tinyledmatrix/matrixSAO/README.md

# matrixSAO
tiny led matrix SAO

see also here:
https://hackaday.io/project/202620
