tinyledmatrix/matrixSAO/Firmware/linkUtilityScreenshoot.png

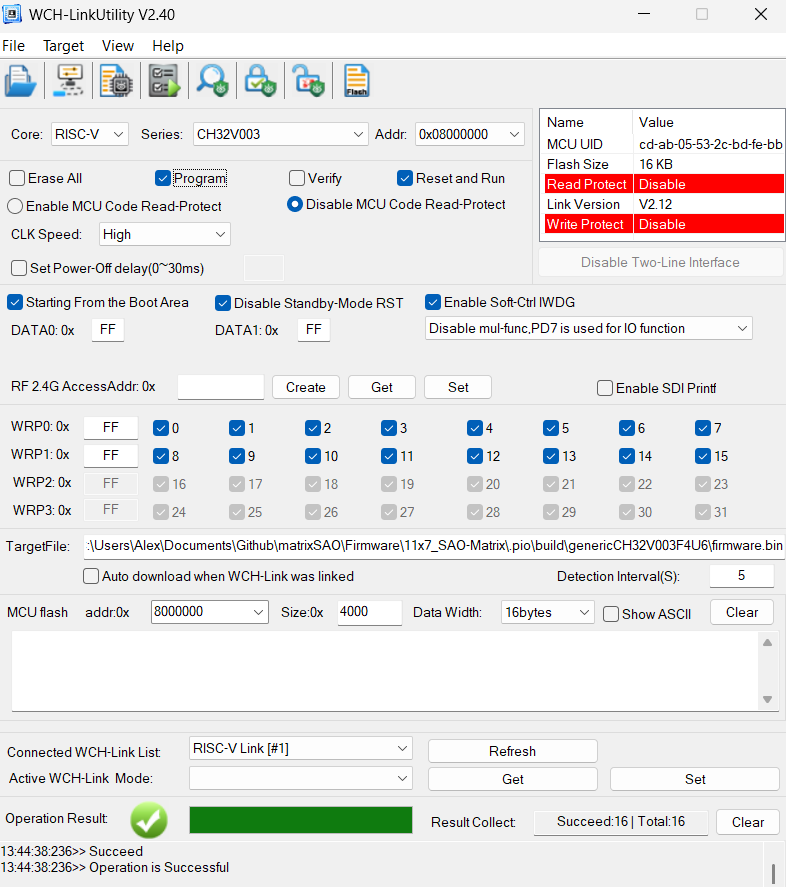
Firmware/linkUtilityScreenshoot.png
