tinyledmatrix/matrixSAO/Mechanical/MatchBoxHolder.3mf

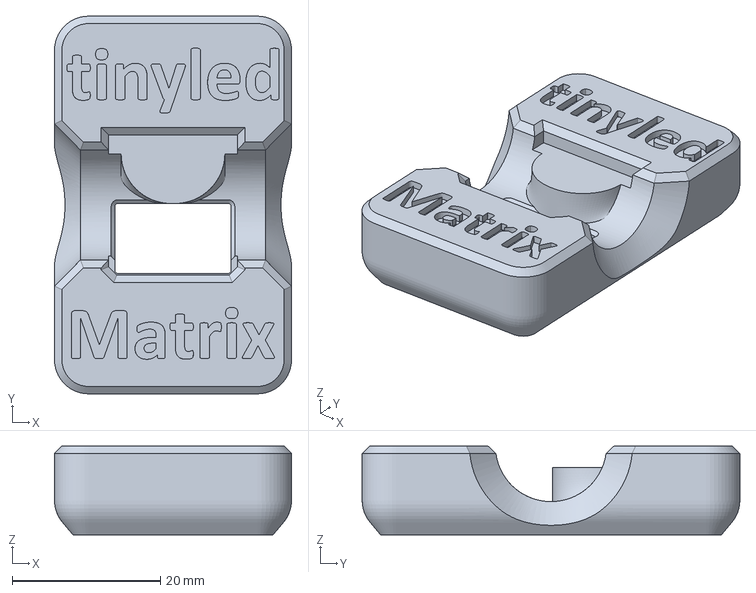
[picture p2: CAD file, 2025-03-15]
Mechanical/MatchBoxHolder.3mf
32.0 x 51.0 x 12.0 mm
