tinyledmatrix/matrixSAO/(list of files, cad)

Other CAD files:
Mechanical/holder.stl
