tinyledmatrix/matrixSAO/Hardware/matrixSAO/matrixSAO.kicad_pcb

## KiCad design Hardware/matrixSAO/matrixSAO.kicad_pcb (2025-02-26)

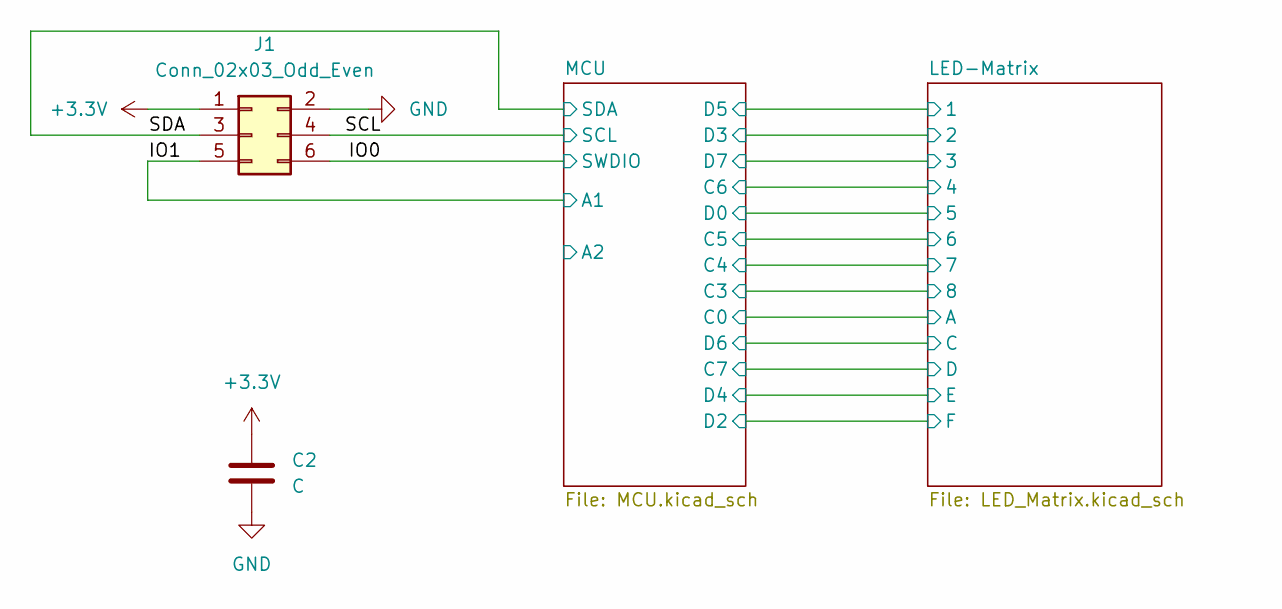
[picture p3: schematic matrixSAO.kicad_sch]

Parts:
C2: C; C_0402_min; LCSC C16772
J1: Conn_02x03_Odd_Even; IDC-Header_2x03_P2.54mm_Vertical; LCSC C4749192

Connections:
+3.3V: C2.2, J1.1; also elsewhere on the board
/IO0: J1.6; also elsewhere on the board
/IO1: J1.5; also elsewhere on the board
/SCL: J1.4; also elsewhere on the board
/SDA: J1.3; also elsewhere on the board
GND: C2.1, J1.2; also elsewhere on the board

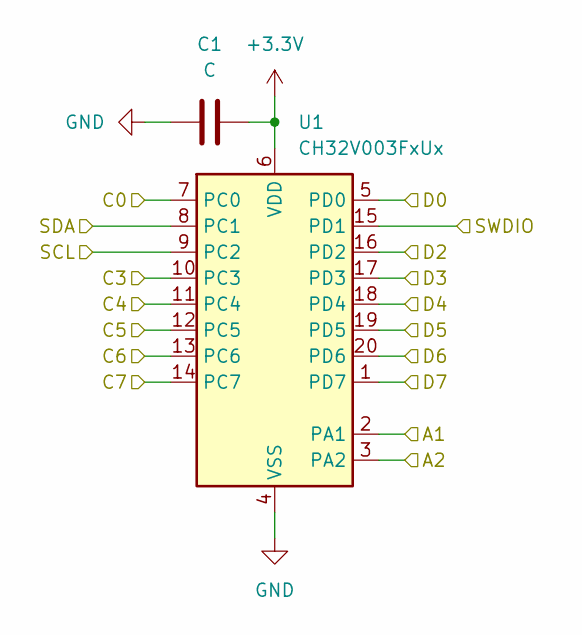
[picture p4: schematic MCU.kicad_sch]

Parts:
C1: C; C_0402_min; LCSC C16772
U1: CH32V003FxUx; QFN-20-1EP_3x3mm_P0.4mm_EP1.65x1.65mm; LCSC C5299908

Connections:
+3.3V: C1.2, U1.6 (VDD); also elsewhere on the board
/IO0: U1.15 (PD1); also elsewhere on the board
/IO1: U1.2 (PA1); also elsewhere on the board
/LED-Matrix/1: U1.19 (PD5); also elsewhere on the board
/LED-Matrix/2: U1.17 (PD3); also elsewhere on the board
/LED-Matrix/3: U1.1 (PD7); also elsewhere on the board
/LED-Matrix/4: U1.13 (PC6); also elsewhere on the board
/LED-Matrix/5: U1.5 (PD0); also elsewhere on the board
/LED-Matrix/6: U1.12 (PC5); also elsewhere on the board
/LED-Matrix/7: U1.11 (PC4); also elsewhere on the board
/LED-Matrix/8: U1.10 (PC3); also elsewhere on the board
/LED-Matrix/A: U1.7 (PC0); also elsewhere on the board
/LED-Matrix/C: U1.20 (PD6); also elsewhere on the board
/LED-Matrix/D: U1.14 (PC7); also elsewhere on the board
/LED-Matrix/E: U1.18 (PD4); also elsewhere on the board
/LED-Matrix/F: U1.16 (PD2); also elsewhere on the board
/MCU/A2: U1.3 (PA2)
/SCL: U1.9 (PC2); also elsewhere on the board
/SDA: U1.8 (PC1); also elsewhere on the board
GND: C1.1, U1.4 (VSS), U1.21 (VSS); also elsewhere on the board

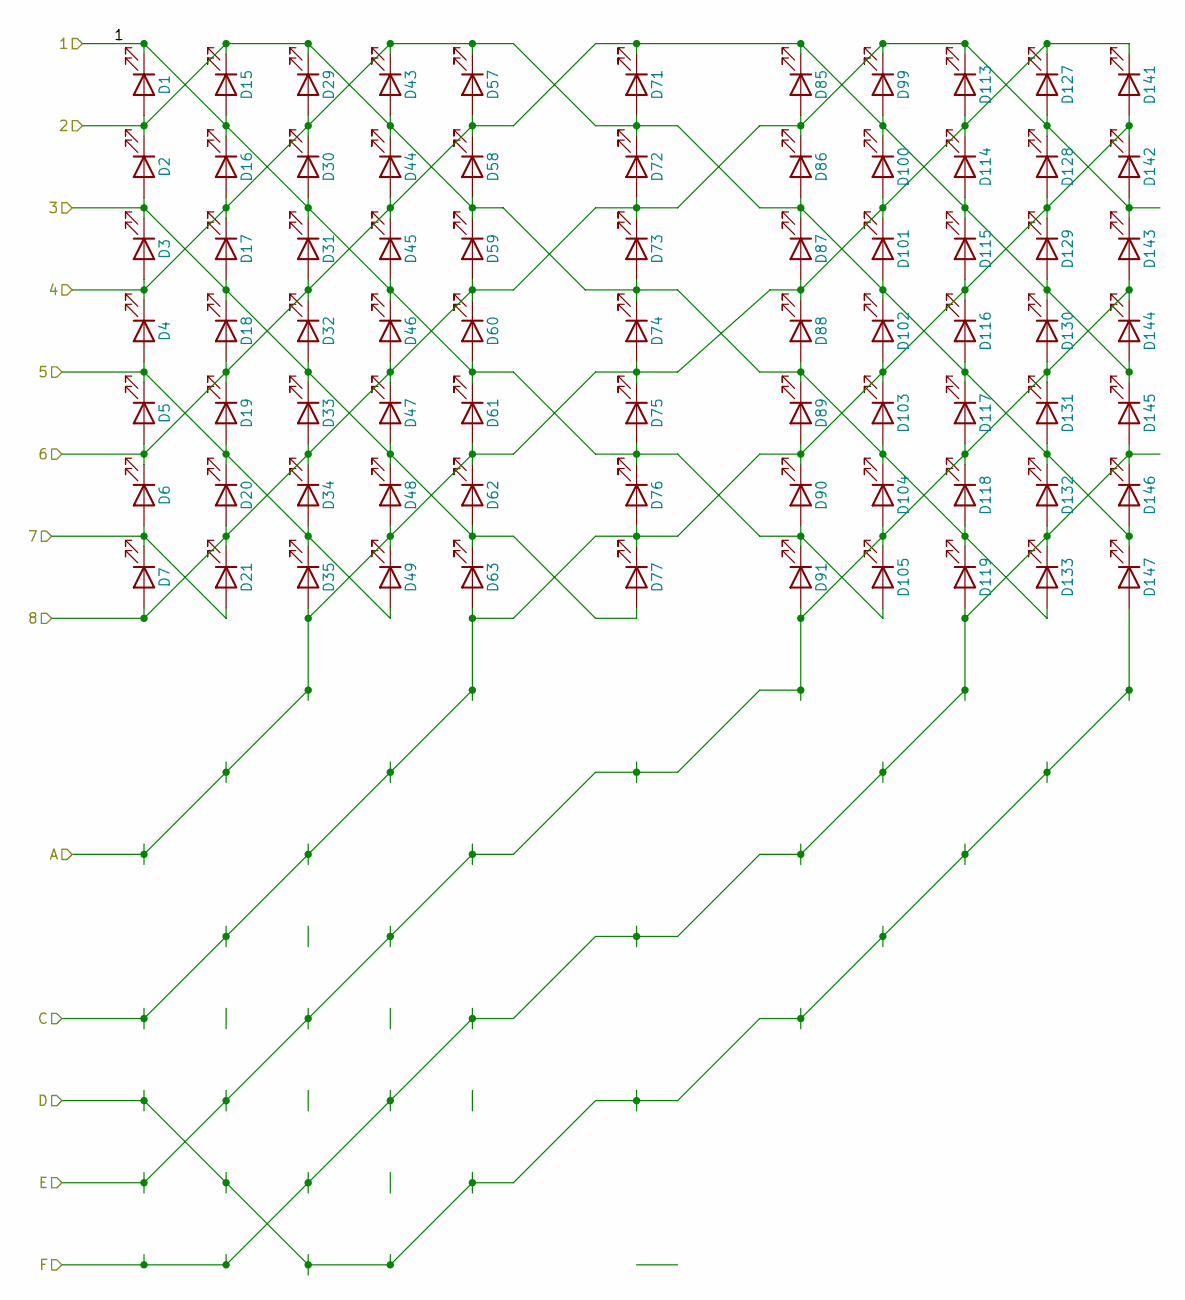
[picture p5: schematic LED_Matrix.kicad_sch]

Parts:
D1, D2, D3, D4, D5, D6, D7, D15, D16, D17, D18, D19, D20, D21, D29, D30, D31, D32, D33, D34, D35, D43, D44, D45, D46, D47, D48, D49, D57, D58, D59, D60, D61, D62, D63, D71, D72, D73, D74, D75, D76, D77, D85, D86, D87, D88, D89, D90, D91, D99, D100, D101, D102, D103, D104, D105, D113, D114, D115, D116, D117, D118, D119, D127, D128, D129, D130, D131, D132, D133, D141, D142, D143, D144, D145, D146, D147: LED; LCSC C965793

Connections:
/LED-Matrix/1: D1.1 (K), D15.2 (A), D16.1 (K), D30.2 (A), D31.1 (K), D45.2 (A), D46.1 (K), D60.2 (A), D61.1 (K), D75.2 (A), D76.1 (K), D90.2 (A), D91.1 (K), D105.2 (A); also elsewhere on the board
/LED-Matrix/2: D1.2 (A), D2.1 (K), D15.1 (K), D29.1 (K), D43.2 (A), D44.1 (K), D58.2 (A), D59.1 (K), D73.2 (A), D74.1 (K), D88.2 (A), D89.1 (K), D103.2 (A), D104.1 (K), D118.2 (A), D119.1 (K), D133.2 (A); also elsewhere on the board
/LED-Matrix/3: D2.2 (A), D3.1 (K), D17.2 (A), D18.1 (K), D32.2 (A), D33.1 (K), D47.2 (A), D48.1 (K), D62.2 (A), D63.1 (K), D77.2 (A); also elsewhere on the board
/LED-Matrix/4: D3.2 (A), D4.1 (K), D16.2 (A), D17.1 (K), D29.2 (A), D30.1 (K), D43.1 (K), D57.1 (K), D71.2 (A), D72.1 (K), D86.2 (A), D87.1 (K), D101.2 (A), D102.1 (K), D116.2 (A), D117.1 (K), D131.2 (A), D132.1 (K), D146.2 (A), D147.1 (K); also elsewhere on the board
/LED-Matrix/5: D4.2 (A), D5.1 (K), D19.2 (A), D20.1 (K), D34.2 (A), D35.1 (K), D49.2 (A); also elsewhere on the board
/LED-Matrix/6: D5.2 (A), D6.1 (K), D18.2 (A), D19.1 (K), D31.2 (A), D32.1 (K), D44.2 (A), D45.1 (K), D57.2 (A), D58.1 (K), D71.1 (K), D85.1 (K), D99.2 (A), D100.1 (K), D114.2 (A), D115.1 (K), D129.2 (A), D130.1 (K), D144.2 (A), D145.1 (K); also elsewhere on the board
/LED-Matrix/7: D6.2 (A), D7.1 (K), D21.2 (A); also elsewhere on the board
/LED-Matrix/8: D7.2 (A), D20.2 (A), D21.1 (K), D33.2 (A), D34.1 (K), D46.2 (A), D47.1 (K), D59.2 (A), D60.1 (K), D72.2 (A), D73.1 (K), D85.2 (A), D86.1 (K), D99.1 (K), D113.1 (K), D127.2 (A), D128.1 (K), D142.2 (A), D143.1 (K); also elsewhere on the board
/LED-Matrix/A: D35.2 (A), D48.2 (A), D49.1 (K), D61.2 (A), D62.1 (K), D74.2 (A), D75.1 (K), D87.2 (A), D88.1 (K), D100.2 (A), D101.1 (K), D113.2 (A), D114.1 (K), D127.1 (K), D141.1 (K); also elsewhere on the board
/LED-Matrix/C: D63.2 (A), D76.2 (A), D77.1 (K), D89.2 (A), D90.1 (K), D102.2 (A), D103.1 (K), D115.2 (A), D116.1 (K), D128.2 (A), D129.1 (K), D141.2 (A), D142.1 (K); also elsewhere on the board
/LED-Matrix/D: D147.2 (A); also elsewhere on the board
/LED-Matrix/E: D91.2 (A), D104.2 (A), D105.1 (K), D117.2 (A), D118.1 (K), D130.2 (A), D131.1 (K), D143.2 (A), D144.1 (K); also elsewhere on the board
/LED-Matrix/F: D119.2 (A), D132.2 (A), D133.1 (K), D145.2 (A), D146.1 (K); also elsewhere on the board

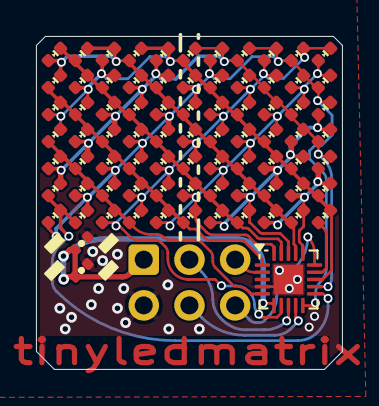
[picture p6: board matrixSAO.kicad_pcb from above]

Board: 2 copper layers, 17.0 x 18.5 mm, 81 parts (1 on the bottom side), 19 nets.
