tinyledmatrix/matrixSAO/Firmware/11x7_SAO-Matrix/src/flash.c

#include "flash.h"
#include "ch32fun.h"

#define RDP_Key                    ((uint16_t)0x00A5)
#define FLASH_KEY1                 ((uint32_t)0x45670123)
#define FLASH_KEY2                 ((uint32_t)0xCDEF89AB)

/* Flash Control Register bits */
#define CR_PG_Set                  ((uint32_t)0x00000001)
#define CR_PG_Reset                ((uint32_t)0xFFFFFFFE)
#define CR_PER_Set                 ((uint32_t)0x00000002)
#define CR_PER_Reset               ((uint32_t)0xFFFFFFFD)
#define CR_MER_Set                 ((uint32_t)0x00000004)
#define CR_MER_Reset               ((uint32_t)0xFFFFFFFB)
#define CR_OPTPG_Set               ((uint32_t)0x00000010)
#define CR_OPTPG_Reset             ((uint32_t)0xFFFFFFEF)
#define CR_OPTER_Set               ((uint32_t)0x00000020)
#define CR_OPTER_Reset             ((uint32_t)0xFFFFFFDF)
#define CR_STRT_Set                ((uint32_t)0x00000040)
#define CR_LOCK_Set                ((uint32_t)0x00000080)
#define CR_PAGE_PG                 ((uint32_t)0x00010000)
#define CR_PAGE_ER                 ((uint32_t)0x00020000)
#define CR_BUF_LOAD                ((uint32_t)0x00040000)
#define CR_BUF_RST                 ((uint32_t)0x00080000)


/*
typedef enum
{
    FLASH_BUSY = 1,
    FLASH_ERROR_PG,
    FLASH_ERROR_WRP,
    FLASH_COMPLETE,
    FLASH_TIMEOUT
} FLASH_Status2;    */

#define EraseTimeout               ((uint32_t)0x000B0000)
#define ProgramTimeout             ((uint32_t)0x00002000)

void FLASH_Unlock(void)
{
    /* Authorize the FPEC of Bank1 Access */
    FLASH->KEYR = FLASH_KEY1;
    FLASH->KEYR = FLASH_KEY2;
}

void FLASH_Lock(void)
{
    FLASH->CTLR |= CR_LOCK_Set;
}

FLASH_Status FLASH_GetBank1Status(void)
{
    FLASH_Status flashstatus2 = FLASH_COMPLETE;

    if((FLASH->STATR & FLASH_FLAG_BANK1_BSY) == FLASH_FLAG_BSY)
    {
        flashstatus2 = FLASH_BUSY;
    }
    else
    {
        if((FLASH->STATR & FLASH_FLAG_BANK1_WRPRTERR) != 0)
        {
            flashstatus2 = FLASH_ERROR_WRP;
        }
        else
        {
            flashstatus2 = FLASH_COMPLETE;
        }
    }
    return flashstatus2;
}

FLASH_Status FLASH_WaitForLastOperation(uint32_t Timeout)
{
    FLASH_Status status = FLASH_COMPLETE;

    status = FLASH_GetBank1Status();
    while((status == FLASH_BUSY) && (Timeout != 0x00))
    {
        status = FLASH_GetBank1Status();
        Timeout--;
    }
    if(Timeout == 0x00)
    {
        status = FLASH_TIMEOUT;
    }
    return status;
}

FLASH_Status FLASH_EraseOptionBytes(void)
{
    uint16_t rdptmp = RDP_Key;

    FLASH_Status status = FLASH_COMPLETE;
    if(/*FLASH_GetReadOutProtectionStatus*/FLASH_GetBank1Status() != RESET)
    {
        rdptmp = 0x00;
    }
    status = FLASH_WaitForLastOperation(EraseTimeout);
    if(status == FLASH_COMPLETE)
    {
        FLASH->OBKEYR = FLASH_KEY1;
        FLASH->OBKEYR = FLASH_KEY2;

        FLASH->CTLR |= CR_OPTER_Set;
        FLASH->CTLR |= CR_STRT_Set;
        status = FLASH_WaitForLastOperation(EraseTimeout);

        if(status == FLASH_COMPLETE)
        {
            FLASH->CTLR &= CR_OPTER_Reset;
            FLASH->CTLR |= CR_OPTPG_Set;
            OB->RDPR = (uint16_t)rdptmp;
            status = FLASH_WaitForLastOperation(ProgramTimeout);

            if(status != FLASH_TIMEOUT)
            {
                FLASH->CTLR &= CR_OPTPG_Reset;
            }
        }
        else
        {
            if(status != FLASH_TIMEOUT)
            {
                FLASH->CTLR &= CR_OPTPG_Reset;
            }
        }
    }
    return status;
}

FLASH_Status FLASH_UserOptionByteConfig(uint16_t OB_IWDG, uint16_t OB_STOP, uint16_t OB_STDBY, uint16_t OB_RST)
{
    FLASH_Status status = FLASH_COMPLETE;

    FLASH->OBKEYR = FLASH_KEY1;
    FLASH->OBKEYR = FLASH_KEY2;
    status = FLASH_WaitForLastOperation(ProgramTimeout);

    if(status == FLASH_COMPLETE)
    {
        FLASH->CTLR |= CR_OPTPG_Set;

        OB->USER = OB_IWDG | (uint16_t)(OB_STOP | (uint16_t)(OB_STDBY | (uint16_t)(OB_RST | (uint16_t)0xE0)));

        status = FLASH_WaitForLastOperation(ProgramTimeout);
        if(status != FLASH_TIMEOUT)
        {
            FLASH->CTLR &= CR_OPTPG_Reset;
        }
    }
    return status;
}

void unlockD7()
{
    //if((FLASH_GetUserOptionByte() & OB_RST_NoEN) == OB_RST_NoEN) return; //already configured
    FLASH_Unlock();
    FLASH_EraseOptionBytes();
    FLASH_UserOptionByteConfig(OB_IWDG_SW, OB_STOP_NoRST, OB_STDBY_NoRST, OB_RST_NoEN);
    FLASH_Lock();
}
