tinyledmatrix/matrixSAO/(commit log)

2025-02-16 ongoign work Schematic
    [LED_Matrix.kicad_sch, MCU.kicad_sch, matrixSAO.kicad_pcb, matrixSAO.kicad_sch]
2025-02-17 some work
    [MCU.kicad_sch, matrixSAO.kicad_sch]
2025-02-26 Order at JLCPPCB
    [LED_Matrix.kicad_sch, MCU.kicad_sch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]
2025-03-15 cleaned Schematic
    [LED_Matrix.kicad_sch]
2025-03-15 Added Firmware
    [MatchBoxHolder.stl, matrixSAO.step]
2025-03-17 fix e/d problem
    two letters were printed over each other, this fixes it.
    [main.c]
